Breadstick-Innovations/Raspberry-Breadstick-Lite/RP2040-Breadstick/RP2040-Breadstick.kicad_pcb

## KiCad design RP2040-Breadstick/RP2040-Breadstick.kicad_pcb (2024-02-15)

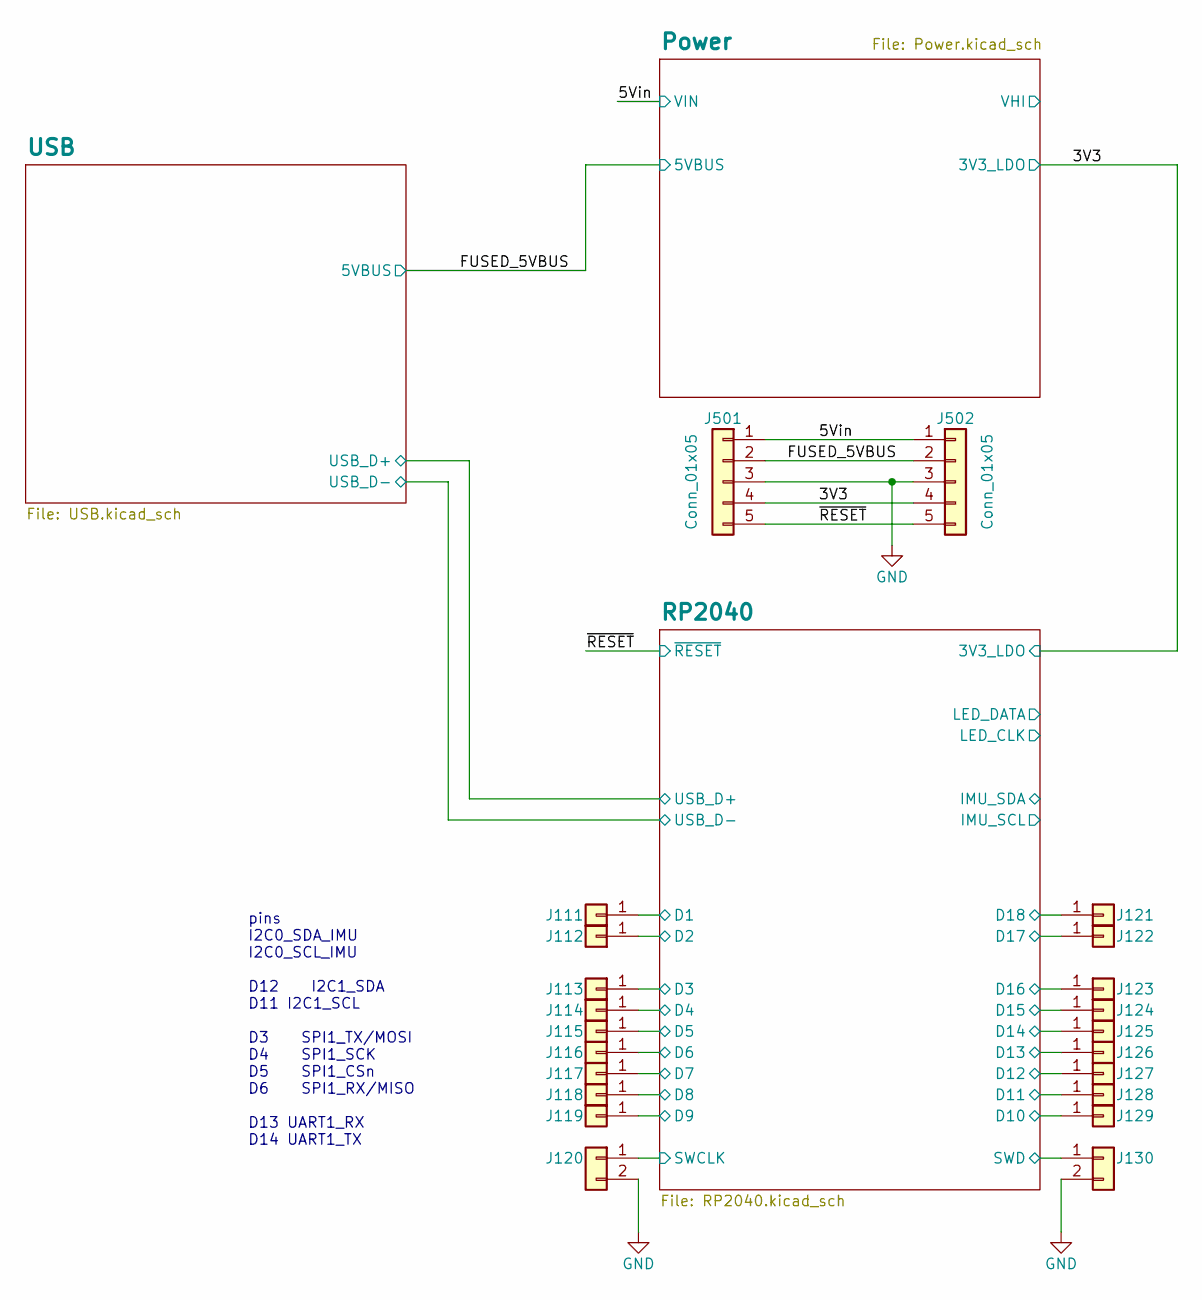
[picture p1: schematic RP2040-Breadstick.kicad_sch, Raspberry Breadstick]

Parts:
J111, J112, J113, J114, J115, J116, J117, J118, J119, J121, J122, J123, J124, J125, J126, J127, J128, J129: Conn_01x01; PinHeader_1x01_P2.54mm_Vertical; JLCPCB P/N C492400
J120, J130: Conn_01x02; PinHeader_1x02_P2.54mm_Vertical; JLCPCB P/N C492401
J501, J502: Conn_01x05; PinHeader_1x05_P2.54mm_Vertical; JLCPCB P/N C492404

Connections:
/3V3: J501.4, J502.4; also elsewhere on the board
/5Vin: J501.1, J502.1; also elsewhere on the board
/FUSED_5VBUS: J501.2, J502.2; also elsewhere on the board
/RP2040/D1: J111.1; also elsewhere on the board
/RP2040/D2: J112.1; also elsewhere on the board
/RP2040/D3: J113.1; also elsewhere on the board
/RP2040/D4: J114.1; also elsewhere on the board
/RP2040/D5: J115.1; also elsewhere on the board
/RP2040/D6: J116.1; also elsewhere on the board
/RP2040/D7: J117.1; also elsewhere on the board
/RP2040/D8: J118.1; also elsewhere on the board
/RP2040/D9: J119.1; also elsewhere on the board
/RP2040/D10: J129.1; also elsewhere on the board
/RP2040/D11: J128.1; also elsewhere on the board
/RP2040/D12: J127.1; also elsewhere on the board
/RP2040/D13: J126.1; also elsewhere on the board
/RP2040/D14: J125.1; also elsewhere on the board
/RP2040/D15: J124.1; also elsewhere on the board
/RP2040/D16: J123.1; also elsewhere on the board
/RP2040/D17: J122.1; also elsewhere on the board
/RP2040/D18: J121.1; also elsewhere on the board
/RP2040/SWCLK: J120.1; also elsewhere on the board
/RP2040/SWD: J130.1; also elsewhere on the board
/~RESET: J501.5, J502.5; also elsewhere on the board
GND: J120.2, J130.2, J501.3, J502.3; also elsewhere on the board

Notes on the sheet:
pins I2C0_SDA_IMU I2C0_SCL_IMU D12 I2C1_SDA D11 I2C1_SCL D3 SPI1_TX/MOSI D4 SPI1_SCK D5 SPI1_CSn D6 SPI1_RX/MISO D13 UART1_RX D14 UART1_TX

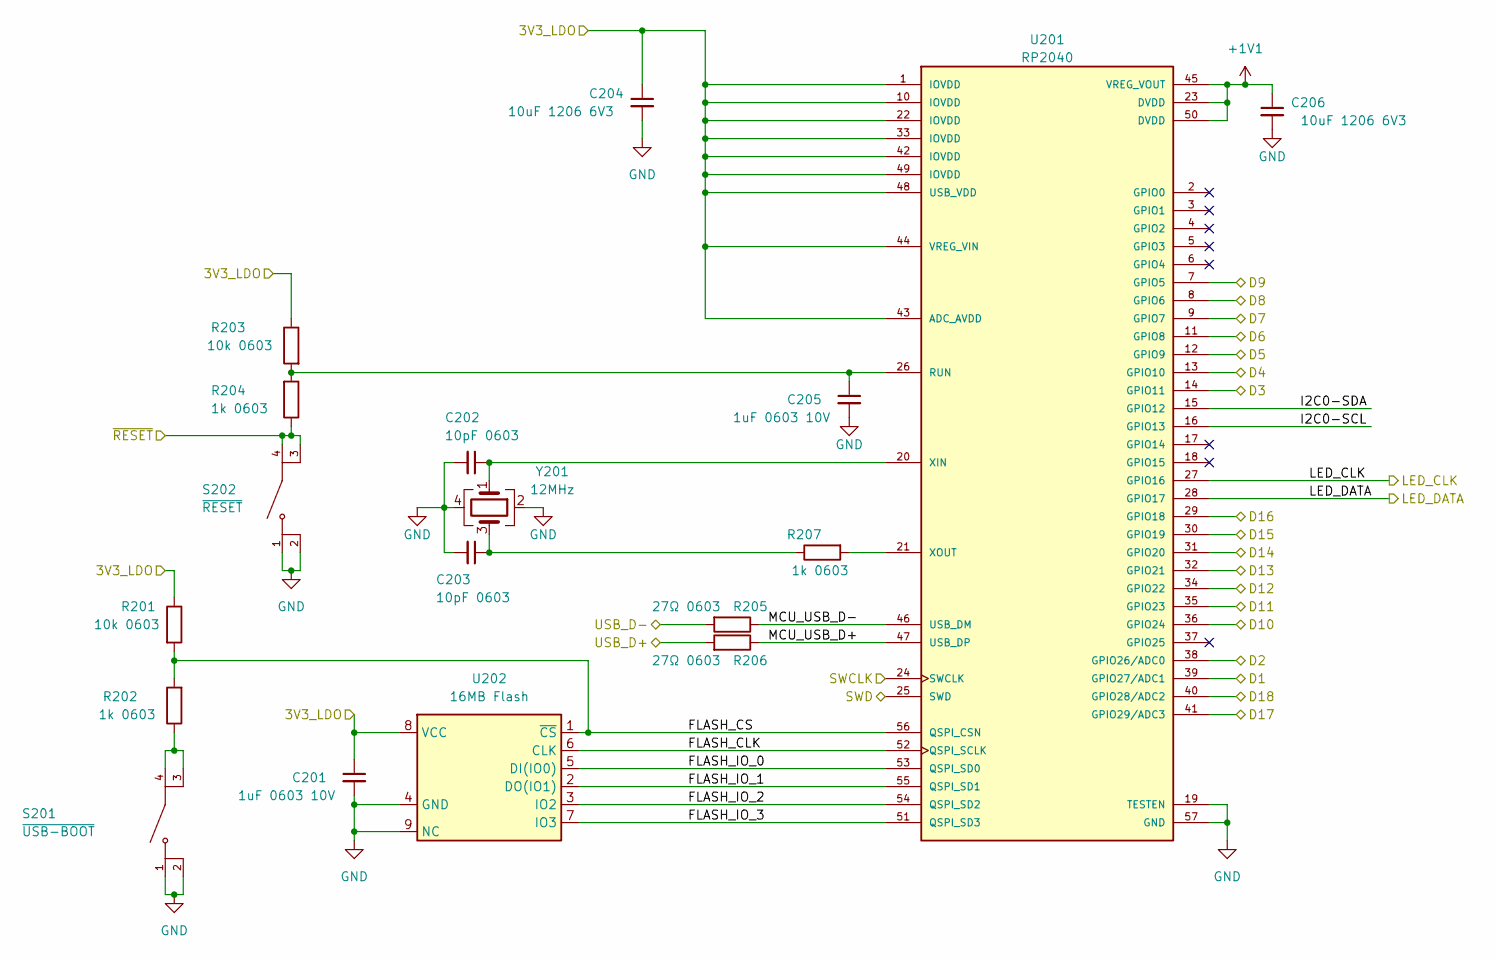
[picture p2: schematic RP2040.kicad_sch, Raspberry Breadstick]

Parts:
C201, C205: 1uF 0603 10V; C_0603_1608Metric; Manufacturer_Part_Number CL05A105KP5NNNC; Digikey 1276-1076-6-ND
C202, C203: 10pF 0603; C_0603_1608Metric; Manufacturer_Part_Number 0603N100J500CT; Digikey 1292-1471-1-ND
C204, C206: 10uF 1206 6V3; C_1206_3216Metric; Manufacturer_Part_Number CL31B106KQHNFNE; Digikey 1276-3107-1-ND
R201, R203: 10k 0603; R_0603_1608Metric; Manufacturer_Part_Number RC0603FR-0710KL; Digikey 311-10.0KHRCT-ND
R202, R204, R207: 1k 0603; R_0603_1608Metric; Manufacturer_Part_Number RC0603FR-071KL; Digikey 311-1.00KHRCT-ND
R205, R206: 27Ω 0603; R_0603_1608Metric; Manufacturer_Part_Number RC0603JR-0727RL; Digikey 311-27GRCT-ND
S201: ~{USB-BOOT}; SW_KMR731NGLFS; PARTREV N/A; Digikey CKN10687CT-ND
S202: ~{RESET}; SW_KMR731NGLFS; PARTREV N/A; Digikey CKN10687TR-ND
U201: RP2040; QFN40P700X700X90-57N; PARTREV 1.6.1; JLCPCB P/N C2040
U202: 16MB Flash; W25Q128JVPIQ-TR; Manufacturer_Part_Number W25Q128JVPIQ TR; Digikey W25Q128JVPIQDKR-ND
Y201: 12MHz; XTAL_ECS-120-10-36Q-ES-TR; Manufacturer_Part_Number ECS-120-10-36Q-ES-TR; Digikey XC2180CT-ND

Connections:
+1V1: C206.1, U201.23 (DVDD), U201.45 (VREG_VOUT), U201.50 (DVDD)
/3V3: C201.1, C204.1, R201.1, R203.1, U201.1 (IOVDD), U201.10 (IOVDD), U201.22 (IOVDD), U201.33 (IOVDD), U201.42 (IOVDD), U201.43 (ADC_AVDD), U201.44 (VREG_VIN), U201.48 (USB_VDD), U201.49 (IOVDD), U202.8 (VCC); also elsewhere on the board
/RP2040/D1: U201.39 (GPIO27/ADC1); also elsewhere on the board
/RP2040/D2: U201.38 (GPIO26/ADC0); also elsewhere on the board
/RP2040/D3: U201.14 (GPIO11); also elsewhere on the board
/RP2040/D4: U201.13 (GPIO10); also elsewhere on the board
/RP2040/D5: U201.12 (GPIO9); also elsewhere on the board
/RP2040/D6: U201.11 (GPIO8); also elsewhere on the board
/RP2040/D7: U201.9 (GPIO7); also elsewhere on the board
/RP2040/D8: U201.8 (GPIO6); also elsewhere on the board
/RP2040/D9: U201.7 (GPIO5); also elsewhere on the board
/RP2040/D10: U201.36 (GPIO24); also elsewhere on the board
/RP2040/D11: U201.35 (GPIO23); also elsewhere on the board
/RP2040/D12: U201.34 (GPIO22); also elsewhere on the board
/RP2040/D13: U201.32 (GPIO21); also elsewhere on the board
/RP2040/D14: U201.31 (GPIO20); also elsewhere on the board
/RP2040/D15: U201.30 (GPIO19); also elsewhere on the board
/RP2040/D16: U201.29 (GPIO18); also elsewhere on the board
/RP2040/D17: U201.41 (GPIO29/ADC3); also elsewhere on the board
/RP2040/D18: U201.40 (GPIO28/ADC2); also elsewhere on the board
/RP2040/FLASH_CLK: U201.52 (QSPI_SCLK), U202.6 (CLK)
/RP2040/FLASH_CS: R201.2, R202.2, U201.56 (QSPI_CSN), U202.1 (~CS)
/RP2040/FLASH_IO_0: U201.53 (QSPI_SD0), U202.5 (DI(IO0))
/RP2040/FLASH_IO_1: U201.55 (QSPI_SD1), U202.2 (DO(IO1))
/RP2040/FLASH_IO_2: U201.54 (QSPI_SD2), U202.3 (IO2)
/RP2040/FLASH_IO_3: U201.51 (QSPI_SD3), U202.7 (IO3)
/RP2040/I2C0-SCL: U201.16 (GPIO13)
/RP2040/I2C0-SDA: U201.15 (GPIO12)
/RP2040/LED_CLK: U201.27 (GPIO16)
/RP2040/LED_DATA: U201.28 (GPIO17)
/RP2040/MCU_USB_D+: R206.1, U201.47 (USB_DP)
/RP2040/MCU_USB_D-: R205.1, U201.46 (USB_DM)
/RP2040/SWCLK: U201.24 (SWCLK); also elsewhere on the board
/RP2040/SWD: U201.25 (SWD); also elsewhere on the board
/RP2040/USB_D+: R206.2; also elsewhere on the board
/RP2040/USB_D-: R205.2; also elsewhere on the board
/~RESET: R204.1, S202.3, S202.4; also elsewhere on the board
GND: C201.2, C202.2, C203.2, C204.2, C205.2, C206.2, S201.1, S201.2, S202.1, S202.2, U201.19 (TESTEN), U201.57 (GND), U202.4 (GND), U202.9 (NC), Y201.2, Y201.4; also elsewhere on the board
unnamed: C203.1, R207.1, Y201.3
unnamed: R202.1, S201.3, S201.4
unnamed: C205.1, R203.2, R204.2, U201.26 (RUN)
unnamed: C202.1, U201.20 (XIN), Y201.1
unnamed: R207.2, U201.21 (XOUT)

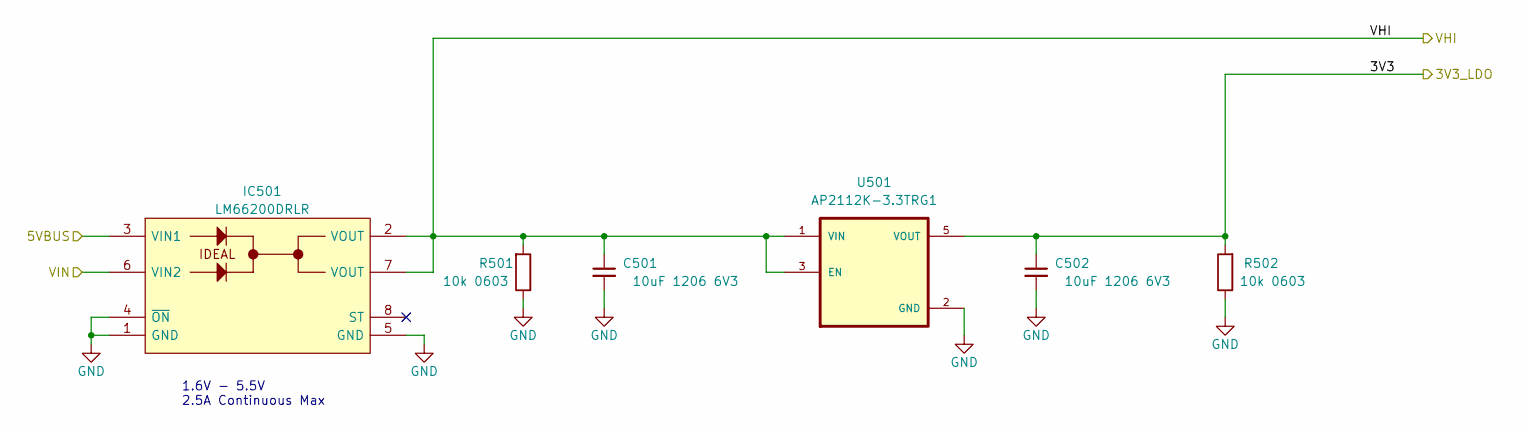
[picture p3: schematic Power.kicad_sch, Raspberry Breadstick]

Parts:
C501, C502: 10uF 1206 6V3; C_1206_3216Metric; Manufacturer_Part_Number CL31B106KQHNFNE; Digikey 1276-3107-1-ND
IC501: LM66200DRLR; SOTFL50P160X60-8L; Mouser Part Number 595-LM66200DRLR
R501, R502: 10k 0603; R_0603_1608Metric; Manufacturer_Part_Number RC0603FR-0710KL; Digikey 311-10.0KHRCT-ND
U501: AP2112K-3.3TRG1; SOT95P285X140-5N; PARTREV 2-2; DigiKey_Part_Number AP2112K-3.3TRG1DITR-ND

Connections:
/3V3: C502.1, R502.2, U501.5 (VOUT); also elsewhere on the board
/5Vin: IC501.6 (VIN2); also elsewhere on the board
/FUSED_5VBUS: IC501.3 (VIN1); also elsewhere on the board
/Power/VHI: C501.1, IC501.2 (VOUT), IC501.7 (VOUT), R501.2, U501.1 (VIN), U501.3 (EN)
GND: C501.2, C502.2, IC501.1 (GND), IC501.4 (~ON), IC501.5 (GND), R501.1, R502.1, U501.2 (GND); also elsewhere on the board

Notes on the sheet:
1.6V - 5.5V 2.5A Continuous Max

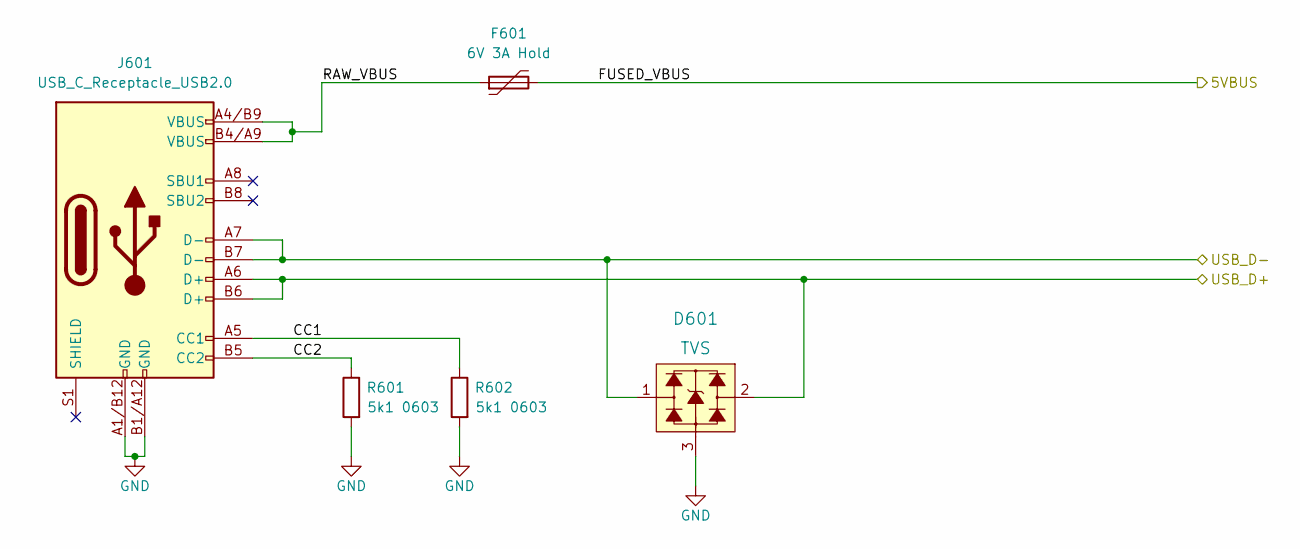
[picture p4: schematic USB.kicad_sch, Raspberry Breadstick]

Parts:
D601: TVS; SOT-23; MPN ESDALD05UE2X; Digikey 1740-ESDALD05UE2XCT-ND
F601: 6V 3A Hold; Fuse_1206_3216Metric; Manufacturer_Part_Number PTSLR12066V300; Digikey 283-PTSLR12066V300CT-ND
J601: USB_C_Receptacle_USB2.0; USB-C-2171790001; Manufacturer_Part_Number 2171790001; Digikey 900-2171790001CT-ND
R601, R602: 5k1 0603; R_0603_1608Metric; Manufacturer_Part_Number RC0603FR-075K1L; Digikey 311-5.10KHRCT-ND

Connections:
/FUSED_5VBUS: F601.2; also elsewhere on the board
/RP2040/USB_D+: D601.2, J601.A6 (D+), J601.B6 (D+); also elsewhere on the board
/RP2040/USB_D-: D601.1, J601.A7 (D-), J601.B7 (D-); also elsewhere on the board
/USB/CC1: J601.A5 (CC1), R602.1
/USB/CC2: J601.B5 (CC2), R601.1
/USB/RAW_VBUS: F601.1, J601.A4/B9 (VBUS), J601.B4/A9 (VBUS)
GND: D601.3, J601.A1/B12 (GND), J601.B1/A12 (GND), R601.2, R602.2; also elsewhere on the board

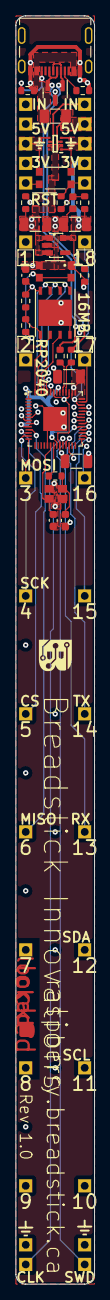
[picture p5: board RP2040-Breadstick.kicad_pcb from above]

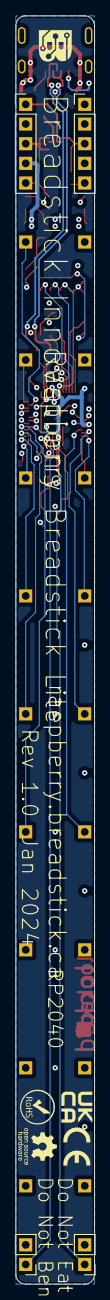
[picture p6: board RP2040-Breadstick.kicad_pcb from below]

Board: 6 copper layers, 10.2 x 163.8 mm, 51 parts (22 on the bottom side), 45 nets.
