Breadstick-Innovations/Raspberry-Breadstick-Lite/(commit log)

2024-02-13 deleted leds and imu in schematic
    [Power.kicad_sch, RP2040-Breadstick.kicad_sch, RP2040.kicad_sch, USB.kicad_sch]
2024-02-13 removed parts not needed for LEDs and IMU
    [RP2040-Breadstick.kicad_pcb]
2024-02-13 cleaned up unused tracks/vias
    [RP2040-Breadstick.kicad_pcb, RP2040-Breadstick.kicad_sch]
2024-02-15 Raspberry Breadstick Lite modifications complete.
    [RP2040-Breadstick.kicad_pcb, RP2040.kicad_sch]
2024-02-15 final adjustments before order
    [RP2040-Breadstick.kicad_pcb]
